JacoboT27/Soft-Gripper-for-Adaptive-Grasping/(commit log)

2026-04-03 ESP32 code
2026-04-03 Circuit Diagram in README
2026-04-04 data and plotting script
    [cylinder_1.csv, cylinder_2.csv, cylinder_3.csv, icosahedron_1.csv, icosahedron_2.csv, icosahedron_3.csv, no_object_1.csv, sphere_1.csv]
